Gernreich/slapstick/step/slapstick-comedy-and-tragedy.step

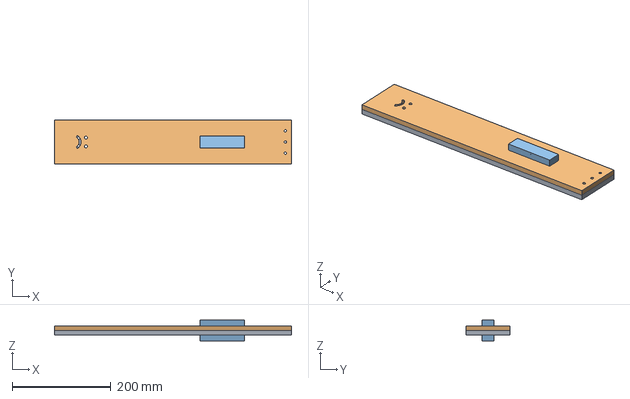
[picture p1: CAD file, 2026-11-08]
step/slapstick-comedy-and-tragedy.step
480.0 x 90.0 x 42.0 mm
