Gernreich/slapstick/(commit log)

2026-08-08 two decorative slapstick faces, cut-ready
    Cut files, a writeup and its generated page. Every dimension in the docs was
    measured out of the SVGs with Inkscape's query interface rather than assumed,
    and the previews are the same files with the stroke thickened, a light ground
    painted in and the view cropped to the part -- geometry untouched.
2026-08-08 slapstick: the actual instrument, not just decorative faces
    Two new sheets, one per side, and a rewrite -- the repo previously described
    only the 100mm face discs and said plainly there was no mechanism. There is
    one now.
    Each sheet carries three 479.7 x 89.7mm paddle blanks and five 90 x 25mm
    handle strips. Three paddles laminate into one slat, the five strips laminate
    into the handle, and the handle glues over an engraved 90 x 25mm rectangle that
    marks its place 294.5mm along. The faces are the comedy and tragedy masks.
    Colour is the cut order, and red is not a cut: red engraves the face outline
    and the glue rectangle, then green (eyes and mouth), blue (three holes), magenta
    (handle stri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
2026-08-08 slapstick: the three holes are a rope hinge
    The build steps said the holes were unused and how the slats join was the
    reader's to decide. They take a rope, and the rope is the hinge -- no pin, no
    hardware. Named in the cut-order table and the parts table too.
    Length and thickness stay open, because they depend on how far apart you want
    the slats to swing; the ~5mm holes set the ceiling and the docs say so.
2026-08-08 remove the two 100mm face discs
    They predated the real slapstick and were unrelated to it -- no hinge, no
    fixing holes, no mechanism -- and once the actual two-sheet build landed they
    were only confusing the repo. Cut files and previews deleted, along with the
    "Also here" section, the ZIP note that counted them and the files-table row.
2026-08-08 docs: name the stock — 3mm Baltic birch plywood
    Every build in these repositories is cut from it, and saying so retires a
    caveat that appeared in all seven: "material and thickness are yours, nothing
    has been validated against cut stock".
    Two places where the thickness was load-bearing and unknown:
    kalimba — the writeup said the sheet "does not record which thickness it
    assumed" for its finger joints. It is 3mm, so the joints are
    sized for 3mm, and substituting means regenerating them.
    slapstick— the laminates now have real numbers: three paddle blanks make a
    9mm slat, five handle strips make a 15mm handle.
    Where the void-free core actuall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
2026-08-08 slapstick: say how the three paddles stack, and why it works
    "Glued face to face" did not say which way round they go. Both outer paddles
    need their engraving showing, so one of them is turned over -- and that is only
    free because the face is symmetric about the paddle's long centreline.
    Measured rather than assumed: the face circle, the mouth and the glue rectangle
    all sit exactly on the centreline, and the two eyes are at +9.00 and -9.00mm.
    So turning a paddle over leaves the face reading the same, which is what makes
    "both sides face out" possible from one drawing.
2026-08-08 slapstick: handle position sets the tip speed, with the numbers
    Confirms what the geometry already implied. The free slat turns about the rope
    hinge, so the assembly is a lever and the ratio is just tip distance divided by
    grip distance, both from the hinge. A closer grip multiplies hand speed more.
    Measured off the sheet rather than argued: the tip is 467mm from the hinge line
    and the engraved handle footprint runs 83 to 173mm, so the tip moves 5.6x your
    hand at the near edge, 3.6x at the centre of the rectangle, 2.7x at the far
    edge.
    Which yields something useful: the handle is 90mm long, so sliding your hand
    along the one already drawn spans a factor of two in tip speed. You can feel
    th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
2026-08-08 slapstick: blue is engrave, cyan takes the rope holes
    Red meant cut in four other repositories here and engrave in this one. Someone
    carrying that habit across would have cut the 50mm face circle clean out of the
    paddle. Engrave is blue now, matching knotwork and kalimba, and the rope holes
    move to cyan so nothing collides.
    Order is unchanged in substance: blue engraves, then green, cyan, magenta,
    black. Verified colour by colour against the parts -- blue carries exactly the
    three face circles and three glue rectangles on each sheet, cyan the nine
    holes. Geometry untouched.
2026-08-08 the middle two stages become orange and cyan
    The order this file cuts in has not changed at all: engrave, then eyes and
    mouth, then the rope-hinge holes, then the handle strips, then the paddle
    outlines. What changed is which colours carry stages two and three, so that all
    seven repositories name their stages the same way.
    That sequence is blue engraves, then green, orange, cyan, black -- black always
    the cut that frees the part, violet always skip. Here the rope holes move from
    cyan to orange and the handle strips from magenta to cyan. Magenta is gone from
    these repositories entirely.
    Blue still engraves and still must not be cut: send it to the cutter and the
    50mm face circle drops out o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
2026-08-08 the previews darken three inks, and the pages now say so
    make-preview.py darkens green, orange and cyan because at full strength they
    fall to 1.28:1, 2.35:1 and 1.17:1 against the cream ground -- all under the 3:1
    graphics minimum, so the cut order could not be read off the picture. That was
    documented in lasermade-tools and nowhere a reader would look.
    Two pages went further and said the opposite. Slapstick: "the cut-order colours
    are untouched." Kalimba: "Colours, geometry and sheet position are untouched."
    Both were true when written and stopped being true when the palette was
    aligned, and neither the audit script nor anything reading markup could see it
    -- a screenshot of the published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
2026-08-08 the writeup link moves above the gallery
    It sat just below the pictures, which on these READMEs means below a table of
    five thumbnails and a caption -- past the fold on a phone, and past the fold on
    GitHub at anything under a tall window. The link to the full build guide was the
    one thing a reader arriving from the video most likely wants, and it was the one
    thing they had to scroll for.
    It now sits directly under the opening description, above the first picture, in
    all seven repositories. High enough to be seen without scrolling, low enough to
    have the sentence of context that says what the writeup is about.
    Nothing else moved: the caption, the LaserMadeMusic credit and the ZIP link keep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
2026-09-04 Ignore xTool project files
    *.xs is the laser's working format: written beside the cut files when a sheet
    is set up to run, large, binary, and regenerated from the SVG every time. The
    SVG is the source. bore-ribbon got this line on 2026-09-03 when two turned up
    there; this is the rest of them, so the next one is caught wherever it lands.
    No repository here tracks a .xs, so nothing is un-tracked by adding it.
    Claude-Session: https://claude.ai/code/session_01VzXwLADAvkvDDCs1E3NrBd
2026-09-07 Stop publishing "Read the writeup" on the writeup itself
    The link points at the page you are already reading. md2html.py's
    <!-- readme-only --> marker drops the paragraph after it from the generated page
    while GitHub renders the comment as nothing, so the README keeps the link where
    it is useful. living-hinge already did this; this repository did not.
    The shipped page happened not to carry the link only because it predated it:
    doc-audit reported "page is current with the markdown" as failing here. So this
    also republishes the page against the current README, which brings across every
    README edit made since the page was last built.
    Audit: 17 passed, 0 failed.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
2026-09-07 Say how many rope-hinge holes there are, and how many handles
    The colour table counted the paddle outlines (3) and handle strips (5) as
    sheet totals but the rope-hinge holes (3) per paddle, where the parts table
    says 9. One convention now: nine, three per paddle.
    Step 2 said "glue the five short strips", but a builder who has cut both
    sheets is holding ten. There is one handle -- you grip it and the other slat
    swings, which is what the lever section assumes -- so the second sheet's five
    are spares. Said so.
    Measured while checking: 32 objects per sheet matching the table object for
    object, and the step-1 symmetry claim holds exactly (circle, mouth and glue
    rectangle on the axis, eyes at +/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
2026-09-07 Centre the rope-hinge holes on the paddle axis
    Step 1 tells you to flip the outer two paddles so both faces read out, and
    justifies it by listing what sits on the long centreline. Everything it listed
    was exact -- circle, mouth and glue rectangle at 0.000, eyes at +/-9.000 -- but
    the three rope holes were not, at 22.13 / 44.63 / 66.78 on an 89.71mm paddle.
    They are the one feature that has to register through all three laminations and
    through the other slat, and a flipped paddle shifted them by up to 0.82mm.
    All 18 holes are now at the axis +/-22.5mm and 0, measured back out of both
    files. Table updated to 22.4 / 44.9 / 67.4mm down, and step 1 now includes the
    holes in the symmetry it claim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
2026-09-08 Warn at the top that a slapstick can injure you or others
    Same treatment as the bullroarer and the buzz disc. The warning sits directly
    under the title on both the page and the README, and links to "Before you
    cut", which is where this repository keeps its hazard note -- there is no
    "Handle it with care" section here, so it points at the section that exists
    rather than inventing one.
    The figures are this document's own. Nearly half a metre comes from the
    479.7mm paddle; 9mm is three 3mm blanks laminated; 2.7 to 5.6 times is the
    lever table, which already gives 5.6x at the handle edge nearest the hinge
    and 2.7x at the far one. Its hazards are not the bullroarer's: this one is a
    lever that st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
2026-09-08 Give the slapstick a "Handle it with care" section, like the other two
    All three now read the same way: the warning under the title, a "Handle it
    with care" section between "Before you cut" and "Files", and the warning
    linking into it. The one-line hazard note that was buried in "Before you cut"
    moves there and grows into the section it should have been.
    Same three-facet shape the bullroarer and the buzz disc use, with this one's
    own hazards rather than theirs -- it is not spun, it is swung and stopped, so
    everything arrives at once when the slats meet.
    Mass is measured, not guessed: the paddle blank is 42812mm2 of material after
    its cut-outs, so a three-ply slat is 262g and the pair with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
2026-09-24 Rebuild with md2html's theme-button fix for narrow screens
    Below 900px the theme button no longer covers the contents list.
2026-10-13 Previews on a white ground (#ffffff), not cream
    Only the ground rect changed; make-preview.py now draws white.
2026-10-13 The hero sheet scales to the page instead of a fixed 620px
    At 400px it pushed the page sideways on a phone. Measured after: the page is
    400px wide in a 400px frame.
2026-10-14 A 3D viewer, assembled from the cut files by viewer.py; .repro claims every drawing and page
2026-10-14 3D viewer: note folds away, theme follows the hub's button
2026-10-22 Link back to all projects at the top of the README and the page
    The rest of the build files now points at lasermademusic.html, where the
    instruments moved when the root page became a directory.
2026-10-23 3D view: fitted to its frame, and framed bare at the top of the page
2026-11-07 Call lasermade-tools' Rust programs, not its Python scripts
    The tools became Rust on 2026-11-07: target/release/<name> in lasermade-tools
    (cargo build --release there) replaces python3 <name>.py, in commands,
    manifests and prose. Pages rebuilt; no generated file changes otherwise.
2026-11-07 The 3D viewer is Rust: viewer.rs on lasermade-tools' turn3d module
    Same page byte for byte, apart from its written-by line naming viewer.rs.
2026-11-08 STEP files of the 3D view, for a CAD program
    One file per design in step/, one solid body per part, written from the
    3D page by lasermade-tools step-export and checked by .repro. Every file
    opens in SolidCraft with every body closed and no warnings.
2026-11-08 Draw the slapstick from parameters; a parametric SolidCraft design
    slapstick.rs draws both sheets from 18 parameters (paddle, face, eyes,
    mouth band, rope holes, handle) and writes the SolidCraft design: the two
    three-paddle slats and their four-strip handles, 14 bodies, every size an
    expression. SolidCraft builds the .sc and the STEP file from it (step-export
    from the 3D view until now). The hand drawing's slips are gone: paddles
    480 x 90 (479.71 x 89.71 before), three 5 mm rope holes on one line.
